ishron256/ToadSuck-Sensor-Test/Hardware/kicad/SmartVent_V3_BOM_testA.csv

 | Value | Datasheet | Footprint | Qty | DNP | Comment | Digi-Key_PN | Manufacturer_Name | Manufacturer_Part_Number | Snaoeda Link | SnapEDA_Link | Snapeda Link | Description
C1,C3,C4,C7,C8,C11,C12,C13,C17,C18,C20 | 0.1 µF | https://www.snapeda.com/parts/0603ZD106KAT2A/AVX/datasheet/ | Capacitor_SMD:C_0603_1608Metric | 11 |  |  |  | AVX | 08055C104KAT4A | https://www.snapeda.com/parts/06035C104MAT4A/KYOCERA%20AVX/view-part/?ab_test_case=b | https://www.snapeda.com/parts/CC0603MRX5R6BB105/Yageo/view-part/?t=1uf%20Capacitor%200603%20&ab_test_case=b | https://www.snapeda.com/parts/0603ZD106KAT2A/AVX/view-part/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 | Unpolarized capacitor,Unpolarized capacitor, small symbol
C2,C14,C15,C19 | 100 µF | https://www.snapeda.com/parts/06035C104MAT4A/KYOCERA%20AVX/datasheet/ | SmartVent_Footprints:SmartVent_Footprint_Capacitor_SMDC_0603_1608Metric_Kyocera_06035C104MAT4A | 4 |  |  |  |  |  |  |  | https://www.snapeda.com/parts/06035C104MAT4A/KYOCERA%20AVX/view-part/?ab_test_case=b | Unpolarized capacitor,Unpolarized capacitor, small symbol
C5,C16 | 22 µF | https://www.snapeda.com/parts/06035C104MAT4A/KYOCERA%20AVX/datasheet/ | Capacitor_SMD:C_0603_1608Metric | 2 |  |  |  | AVX | 06034D226MAT2A |  |  | https://www.snapeda.com/parts/06035C104MAT4A/KYOCERA%20AVX/view-part/?ab_test_case=b | Unpolarized capacitor,Unpolarized capacitor, small symbol
C6 | 1uF | https://www.snapeda.com/parts/CC0603MRX5R6BB105/Yageo/datasheet/ | SmartVent_Footprints:SmartVent_Footprint_C_0603_1608Metric_Yageo_CC0603MRX5R6BB105 | 1 |  |  |  | Yageo | CC0603MRX5R6BB105 |  | https://www.snapeda.com/parts/CC0603MRX5R6BB105/Yageo/view-part/?t=1uf%20Capacitor%200603%20&ab_test_case=b |  | Unpolarized capacitor
C9,C10,C21 | 1.5nF | https://www.snapeda.com/parts/06034D155MAT2A/AVX/datasheet/ | Capacitor_SMD:C_0603_1608Metric | 3 |  |  |  |  |  |  |  |  | Unpolarized capacitor, small symbol
D1,D2,D3,D4,D6,D7 | PDS1040-13 | https://www.snapeda.com/parts/PDS1040-13/Diodes%20Inc./datasheet/ | PDS1040-13:DIO_PDS1040-13 | 6 |  |  |  |  |  |  | https://www.snapeda.com/parts/PDS1040-13/Diodes+Inc./view-part/?ref=snap |  | Diode Schottky 40V 10A 3Pin PowerDI 5 | Diodes Inc PDS1040-13
D5,D9 | LED | https://www.snapeda.com/parts/SMLE12BC7TT86/Rohm/datasheet/ | SML-D12V1WT86:LED_SML-D12V1WT86 | 2 |  |  |  |  |  |  | https://www.snapeda.com/parts/SMLD12V1WT86/Rohm/view-part/?ref=snap |  | Red 630nm LED Indication - Discrete 2.2V 0603 (1608 Metric)
J1 | Pwr In | https://www.molex.com/en-us/products/part-detail/1053092102?display=pdf | Connector_Molex:Molex_Nano-Fit_105309-xx02_1x02_P2.50mm_Vertical | 1 |  |  |  |  |  |  |  |  | Generic connector, single row, 01x02, script generated (kicad-library-utils/schlib/autogen/connector/)
J2 | USB4085-GF-A_REVA4 | https://www.snapeda.com/parts/USB4085-GF-A/Global%20Connector%20Technology/datasheet/ | USB4085-GF-A_REVA4:GCT_USB4085-GF-A_REVA4 | 1 |  |  |  |  |  |  | https://www.snapeda.com/parts/USB4085-GF-A/Global+Connector+Technology/view-part/?ref=snap |  | USB-C (USB TYPE-C) USB 2.0 Receptacle Connector 24 (16+8 Dummy) Position Through Hole, Right Angle, low cost, 3.46mm profile, 16 pin, horizontal, Top mount
J3 | Micro_SD_Card | https://www.we-online.com/components/products/datasheet/693072010801.pdf | SmartVent_Footprints:SmartVent_Footprint_microSD_HC_Wuerth_693072010801 | 1 |  |  |  |  |  |  |  |  | Micro SD Card Socket
J4 | BOOT Jumper | http://www.jst-mfg.com/product/pdf/eng/eXH.pdf | Connector_JST:JST_EH_B3B-EH-A_1x03_P2.50mm_Vertical | 1 |  |  |  |  |  |  |  |  | Generic connector, single row, 01x03, script generated (kicad-library-utils/schlib/autogen/connector/)
J5 | B3B-XH-A | https://www.snapeda.com/parts/B3B-XH-A/JST%20Sales/datasheet/ | B3B-XH-A:JST_B3B-XH-A | 1 |  |  |  |  |  |  | https://www.snapeda.com/parts/B3B-XH-A/JST/view-part/?ref=snap |  | Connector Header Through Hole 3 position 0.098 (2.50mm)
J6,J8 | Snsr Conn | https://www.snapeda.com/parts/B6B-XH-A(LF)(SN)/JST%20Sales%20America%20Inc./datasheet/ | B6B-XH-A_LF__SN_:JST_B6B-XH-A_LF__SN_ | 2 |  |  |  |  |  |  | https://www.snapeda.com/parts/B6B-XH-A(LF)(SN)/JST/view-part/?ref=snap |  | Connector Header Through Hole 6 position 0.098 (2.50mm)
J7 | Ext Fan | http://www.jst-mfg.com/product/pdf/eng/eXH.pdf | B2B_XH_A:JST_B2B-XH-A | 1 |  |  |  |  |  |  |  |  | CONN HEADER VERT 2POS 2.5MM
J15 | FAN 1 | http://www.jst-mfg.com/product/pdf/eng/eXH.pdf | B2B_XH_A:JST_B2B-XH-A | 1 |  |  | 455-2247-ND |  |  |  |  |  | CONN HEADER VERT 2POS 2.5MM
J17 | FAN 2 | http://www.jst-mfg.com/product/pdf/eng/eXH.pdf | B2B_XH_A:JST_B2B-XH-A | 1 |  |  | 455-2247-ND |  |  |  |  |  | CONN HEADER VERT 2POS 2.5MM
Q1,Q4,Q6 | DMP6023LFG-7 | https://www.diodes.com//assets/Datasheets/DMP6023LFG.pdf | LIB_DMP6023LFG-7:DMP4013LFG7 | 3 |  |  |  | Diodes Incorporated | DMP6023LFG-7 |  |  |  | MOSFET P-Ch 60V Enh Mode 20Vgs 53.1nC 2569pF
Q2,Q3,Q5 | 2N7002K | https://www.diodes.com/assets/Datasheets/ds30896.pdf | Package_TO_SOT_SMD:SOT-23 | 3 |  |  |  |  |  |  |  |  | 0.38A Id, 60V Vds, N-Channel MOSFET, SOT-23
R1 | 5.1k Ohm | https://www.snapeda.com/parts/ERA-3VEB5101V/Panasonic%20Electronic%20Components/view-part/ | Resistor_SMD:R_0603_1608Metric | 1 |  |  |  |  |  |  |  | https://www.snapeda.com/parts/ERA-3VEB5101V/Panasonic%20Electronic%20Components/view-part/ | Resistor, small US symbol
R2,R3,R32 | 10 Ohm | https://www.snapeda.com/parts/RCP0603B10R0JS2/Vishay/datasheet/,https://www.vishay.com/docs/20035/dcrcwe3.pdf | Resistor_SMD:R_0603_1608Metric | 3 |  |  |  |  |  |  |  |  | Resistor,Resistor, small US symbol
R4,R5,R6,R8,R10,R14,R16,R19,R20,R21,R27,R29,R30,R31 | 10K Ohm | https://www.snapeda.com/parts/CRGCQ0805F10K/TE%20Connectivity/datasheet/ | Resistor_SMD:R_0603_1608Metric | 14 |  |  |  |  |  |  | https://www.snapeda.com/parts/CRGCQ0603F10K/TE%20Connectivity/view-part/ |  | Resistor, small US symbol
R7,R13,R28 | 27 Ohm | https://www.snapeda.com/parts/CRCW060327R0FKEA/Vishay%20Dale/datasheet/ | Resistor_SMD:R_0603_1608Metric | 3 |  |  |  |  |  |  |  |  | Resistor, small US symbol
R9,R18 | 10K Ohm | https://www.snapeda.com/parts/CRGCQ0603F10K/TE%20Connectivity/datasheet/ | Resistor_SMD:R_0603_1608Metric | 2 |  |  |  |  |  |  | https://www.snapeda.com/parts/CRGCQ0603F10K/TE%20Connectivity/view-part/ |  | Resistor, small US symbol
R11 | 330 Ohm | https://www.snapeda.com/parts/ERJ-S03J331V/Panasonic/datasheet/ | Resistor_SMD:R_0603_1608Metric | 1 |  |  |  |  |  |  | https://www.snapeda.com/parts/ERJ-S03J331V/Panasonic/view-part/?t=330%20Ohm%200608%20resistor&ab_test_case=b |  | Resistor, small US symbol
R12 | 560 Ohm | https://www.snapeda.com/parts/ERJ-8ENF5600V/Panasonic/datasheet/ | Resistor_SMD:R_0603_1608Metric | 1 |  |  |  |  |  |  | https://www.snapeda.com/parts/ERA-3VEB5600V/Panasonic%20Electronic%20Components/view-part/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 |  | Resistor, small US symbol
R15,R26 | 1K Ohm | https://www.snapeda.com/parts/MCT06030E1001BP500/Vishay/view-part/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 | Resistor_SMD:R_0603_1608Metric | 2 |  |  |  |  |  |  |  |  | Resistor, small US symbol
R17 | 4700 Ohm | https://www.snapeda.com/parts/ERJ-S03F4700V/Panasonic/datasheet/ | Resistor_SMD:R_0603_1608Metric | 1 |  |  |  |  |  |  | https://www.snapeda.com/parts/RSF1JB1K00/SEI%20Stackpole%20Electronics/view-part/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 |  | Resistor, small US symbol
R22 | 5.1k Ohm | https://www.snapeda.com/parts/AC0603FR-135K1L/Yageo/view-part/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 | Resistor_SMD:R_0603_1608Metric | 1 |  |  |  |  |  |  |  |  | Resistor, small US symbol
R23 | 100K Ohm | https://www.snapeda.com/parts/RT0603BRB07100KL/Yageo/datasheet/ | Resistor_SMD:R_0603_1608Metric | 1 |  |  |  |  |  |  |  |  | Resistor, small US symbol
R24 | 120K Ohm | https://www.snapeda.com/parts/ERJPA3D1203V/Panasonic/datasheet/ | Resistor_SMD:R_0603_1608Metric | 1 |  |  |  |  |  |  |  |  | Resistor, small US symbol
R25 | 100 Ohm | https://www.snapeda.com/parts/RT0603BRB07100KL/Yageo/datasheet/ | Resistor_SMD:R_0603_1608Metric | 1 |  |  |  |  |  |  |  |  | Resistor, small US symbol
S2 | 1825967-1 | https://www.snapeda.com/parts/1825967-1/TE%20Connectivity/datasheet/ | 1825967-1:SW_1825967-1 | 1 |  | 1825967-1 |  |  |  |  | https://www.snapeda.com/parts/1825967-1/TE+Connectivity+%252F+DEUTSCH/view-part/?ref=snap |  | Switch Tactile OFF (ON) SPST Round Button PC Pins 0.05A 24VDC 1.57N Thru-Hole
U1 | TPD4E001DRLRG4 | https://www.snapeda.com/parts/SDA004-7/Diodes%20Inc./datasheet/ | TPD4E001DRLRG4:SOTFL50P160X60-6N | 1 |  |  |  |  |  |  | https://www.snapeda.com/parts/TPD4E001DRLRG4/Texas+Instruments/view-part/?ref=snap |  | Low-capacitance 4-channel +/-15-k-V ESD protection array for high-speed data interfaces 6-SOT-5X3 -40 to 85
U2 | ESP32-S3-WROOM-1 | https://www.espressif.com/sites/default/files/documentation/esp32-s3-wroom-1_wroom-1u_datasheet_en.pdf | Library_2:XCVR_ESP32-S3-WROOM-1-N4_EP | 1 |  |  |  |  |  |  |  |  | 2.4 GHz WiFi (802.11 b/g/n) and Bluetooth Â® 5 (LE) module Built around ESP32S3 series of SoCs, Xtensa Â® dualcore 32bit LX7 microprocessor Flash up to 16 MB, PSRAM up to 8 MB 36 GPIOs, rich set of peripherals Onboard PCB antenna
U3 | BME280 | https://www.bosch-sensortec.com/media/boschsensortec/downloads/datasheets/bst-bme280-ds002.pdf | Package_LGA:Bosch_LGA-8_2.5x2.5mm_P0.65mm_ClockwisePinNumbering | 1 |  |  |  |  |  |  |  |  | 3-in-1 sensor, humidity, pressure, temperature, I2C and SPI interface, 1.71-3.6V, LGA-8
U4 | TPD3E001DRLRG4 | https://www.snapeda.com/parts/TPD3E001DRLRG4/Texas%20Instruments/datasheet/ | TPD3E001DRLRG4:SOT50P160X60-5N | 1 |  |  |  |  |  |  | https://www.snapeda.com/parts/TPD3E001DRLRG4/Texas+Instruments/view-part/?ref=snap |  | Low-capacitance 3-channel +/-15K-V ESD-protection array for high-speed data interfaces 5-SOT-5X3 -40 to 85
U11 | LM317 | http://www.ti.com/lit/ds/symlink/lm317.pdf | Package_TO_SOT_SMD:SOT-223-3_TabPin2 | 1 |  |  |  |  |  |  | https://www.snapeda.com/parts/LM317AT/Texas%20Instruments/view-part/?ref=search&t=LM317 |  | 1.5A 35V Adjustable Linear Regulator, SOT-223
