ishron256/ToadSuck-Sensor-Test/Hardware/kicad/SmartVent_V3.pdf

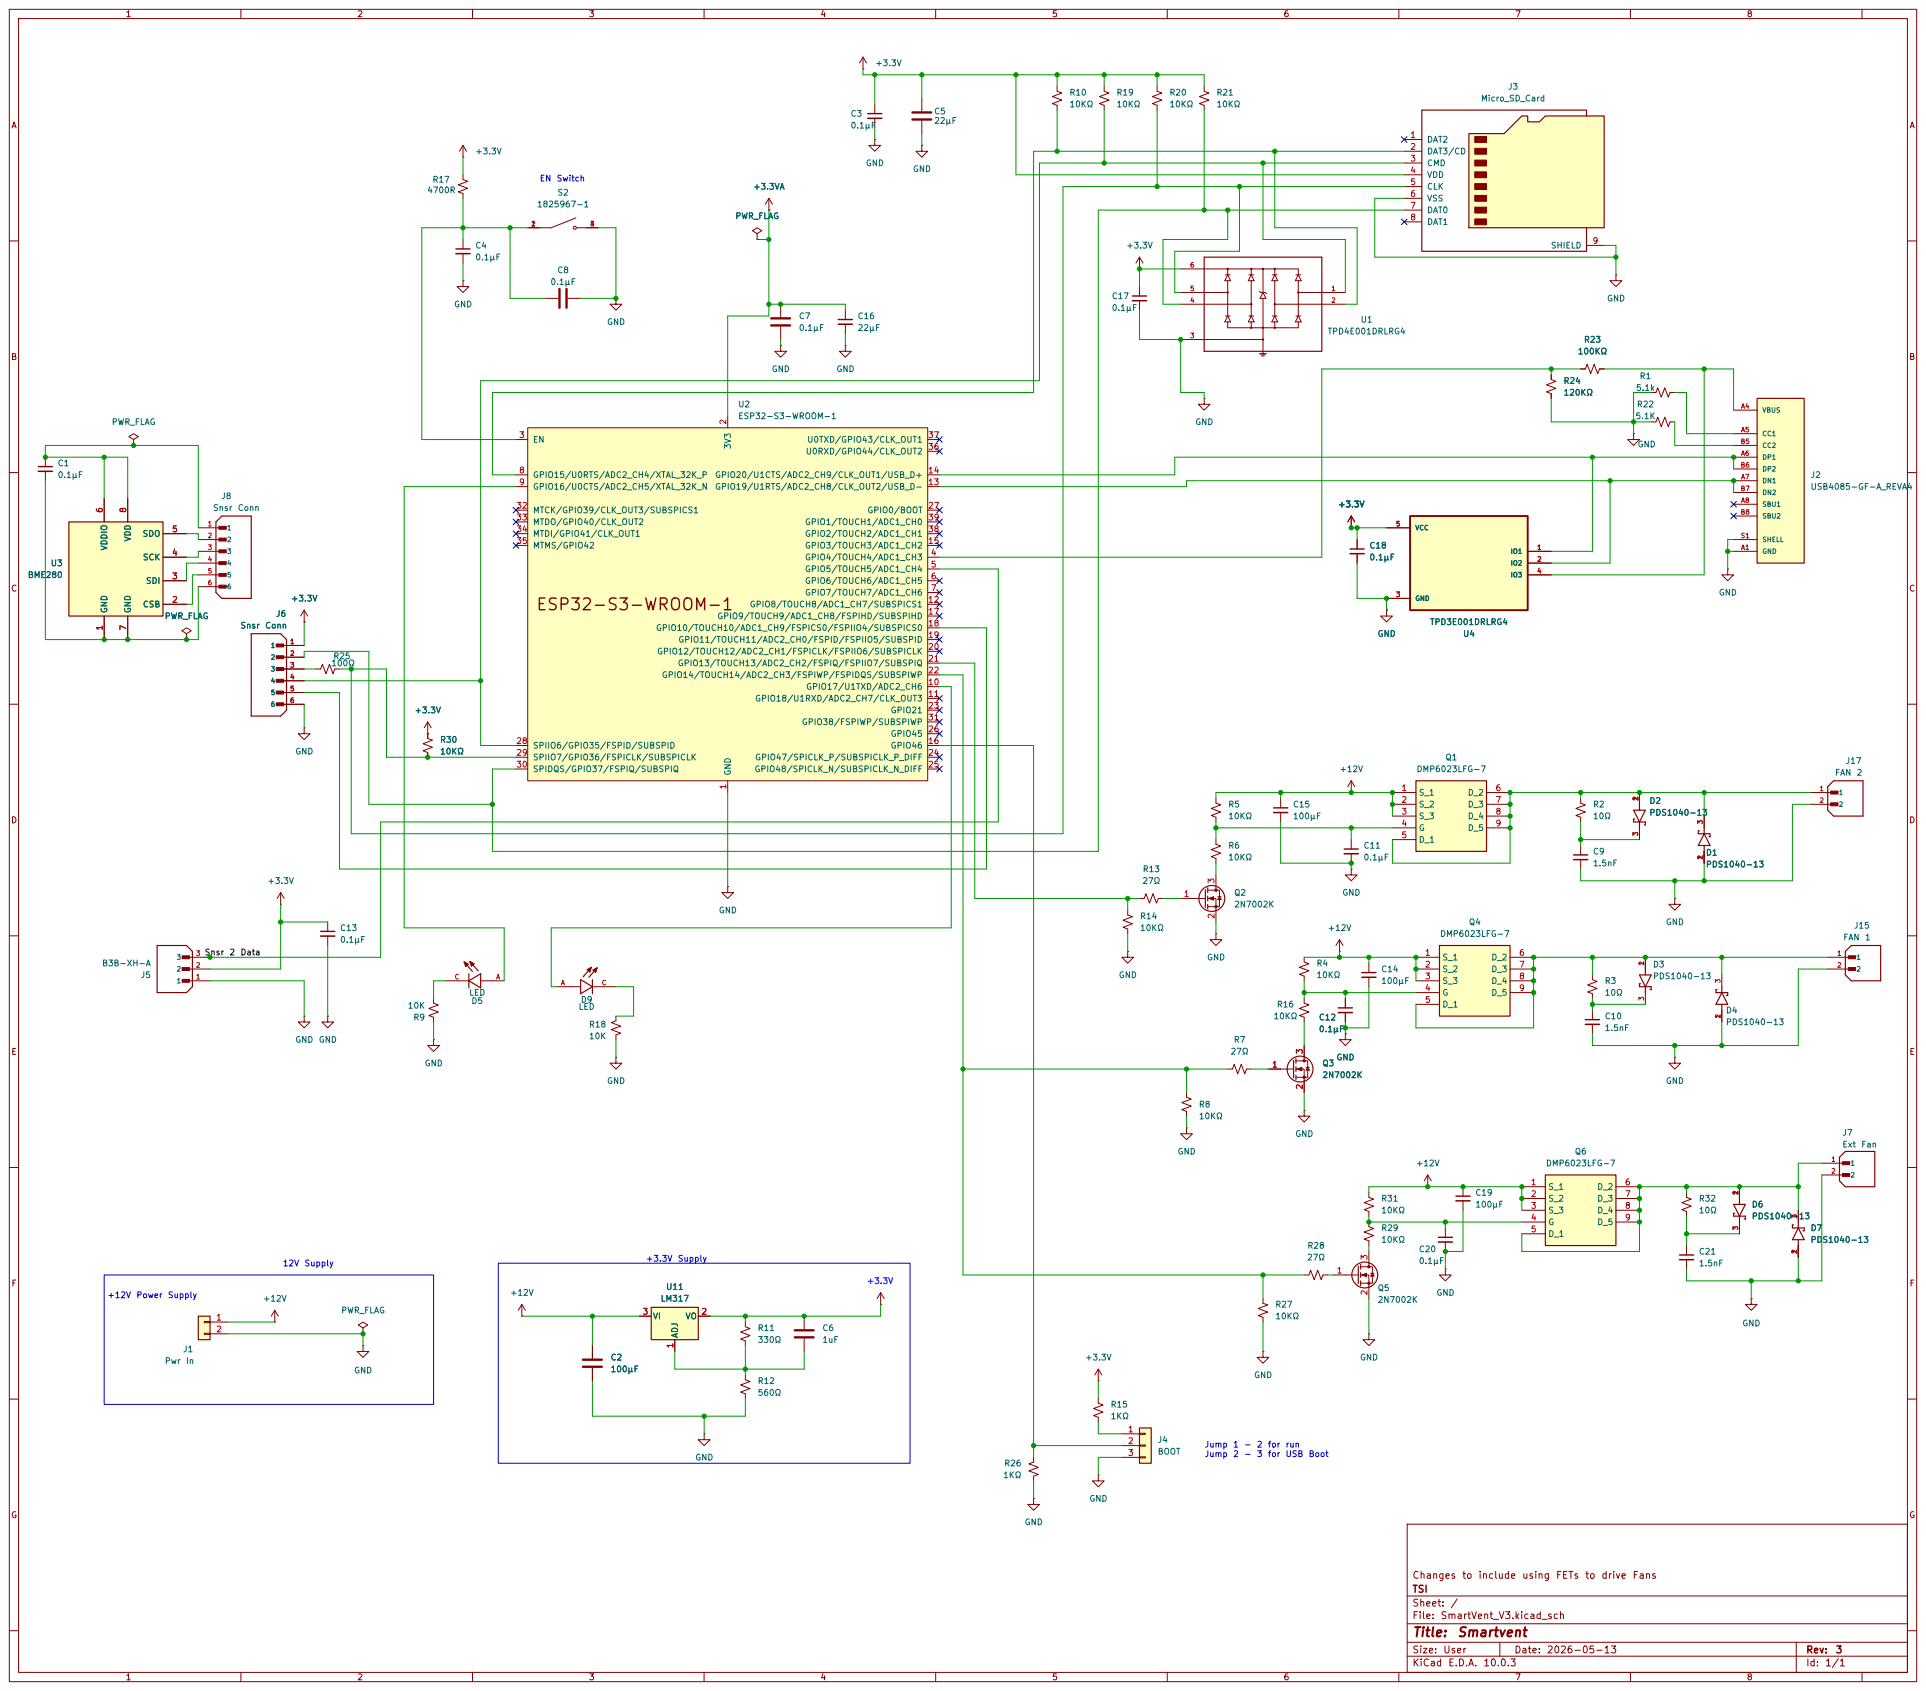
[picture p1: page 1]

Jump 2 - 3 for USB Boot +3.3V Supply 12V Supply

Changes to include using FETs to drive Fans R11

Size: User | Rev: 3
KiCad E.D.A. 10.0.3 | Id: 1/1
