ishron256/ToadSuck-Sensor-Test/Hardware/kicad/SmartVent_V3-B_Cu.pdf

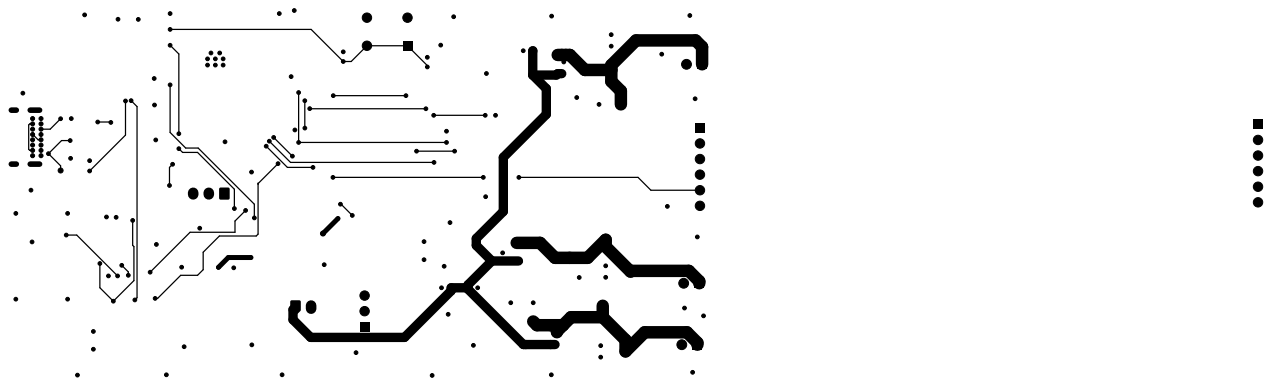
[picture p2: page 1]
