ishron256/ToadSuck-Sensor-Test/Hardware/kicad/SmartVent_V3-B_Mask.pdf

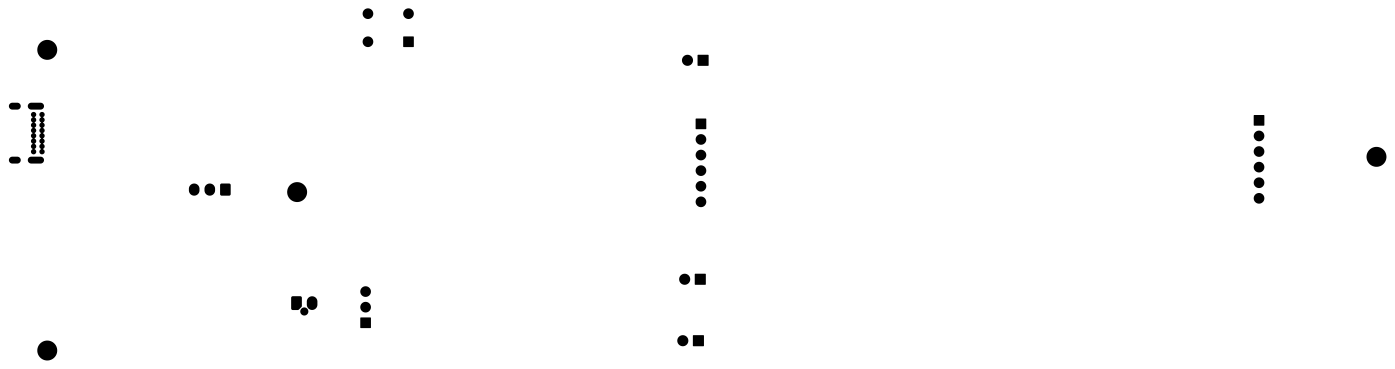
[picture p3: page 1]
