ishron256/ToadSuck-Sensor-Test/Hardware/kicad/SmartVent_V3-F_Cu.pdf

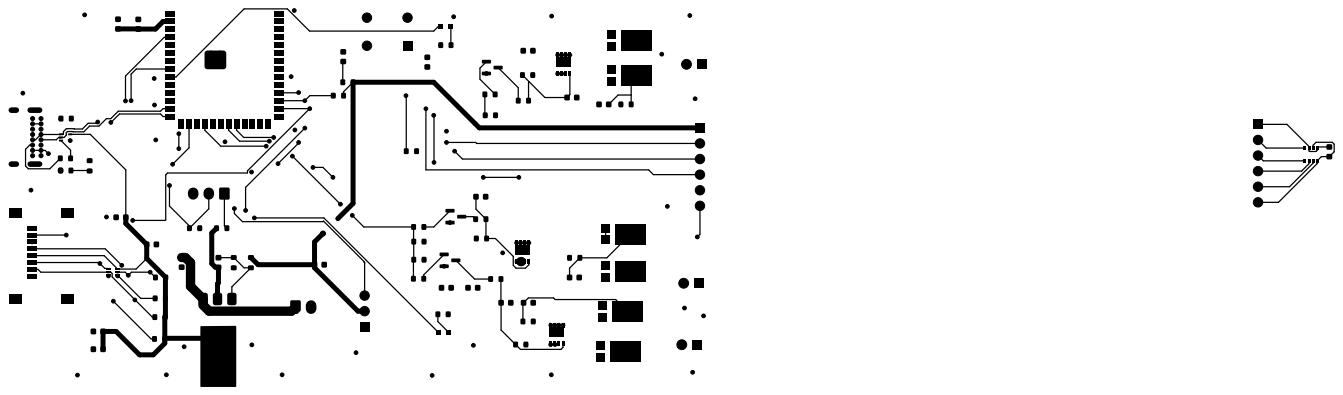
[picture p4: page 1]
