ishron256/ToadSuck-Sensor-Test/Hardware/kicad/SmartVent_V3-F_Mask.pdf

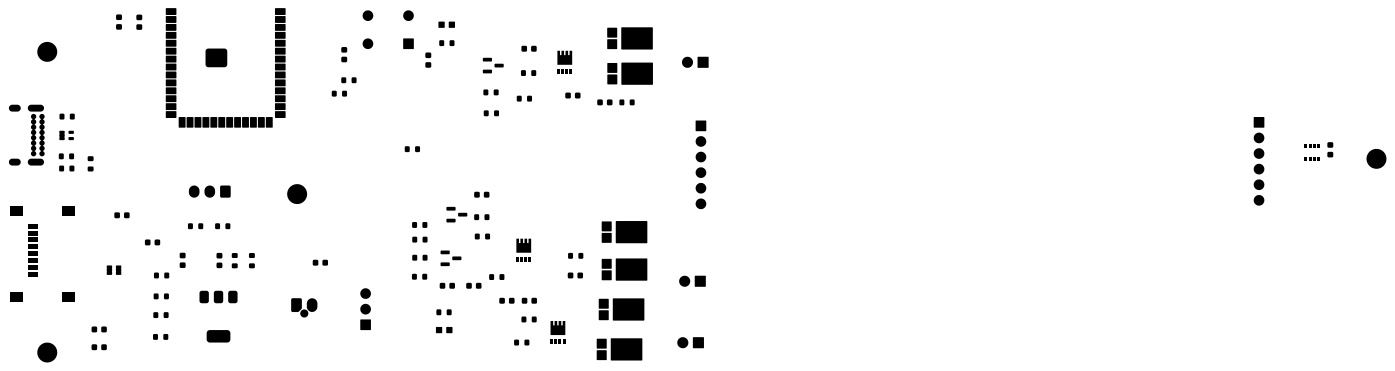
[picture p5: page 1]
