ishron256/ToadSuck-Sensor-Test/Hardware/kicad/SmartVent_V3-F_Paste.pdf

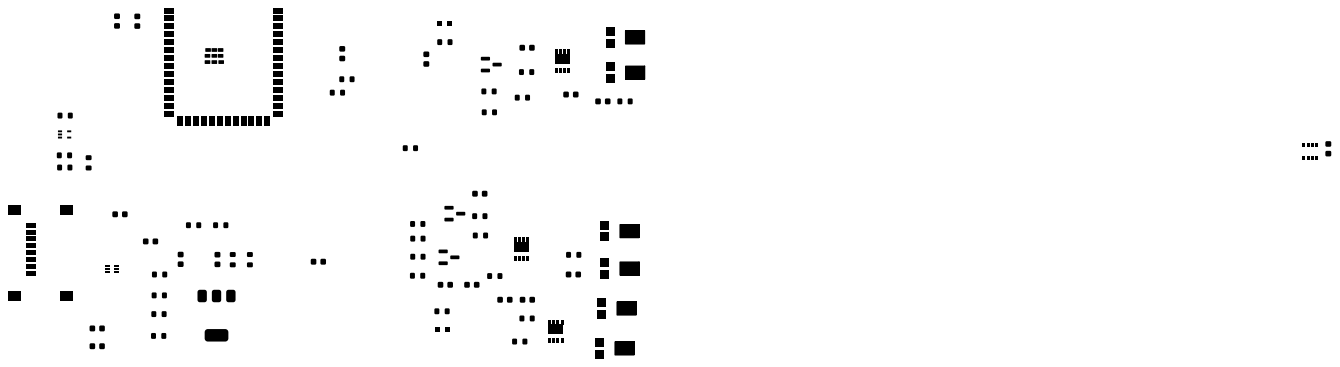
[picture p6: page 1]
