ishron256/ToadSuck-Sensor-Test/Hardware/kicad/SmartVent_V3-F_Silkscreen.pdf

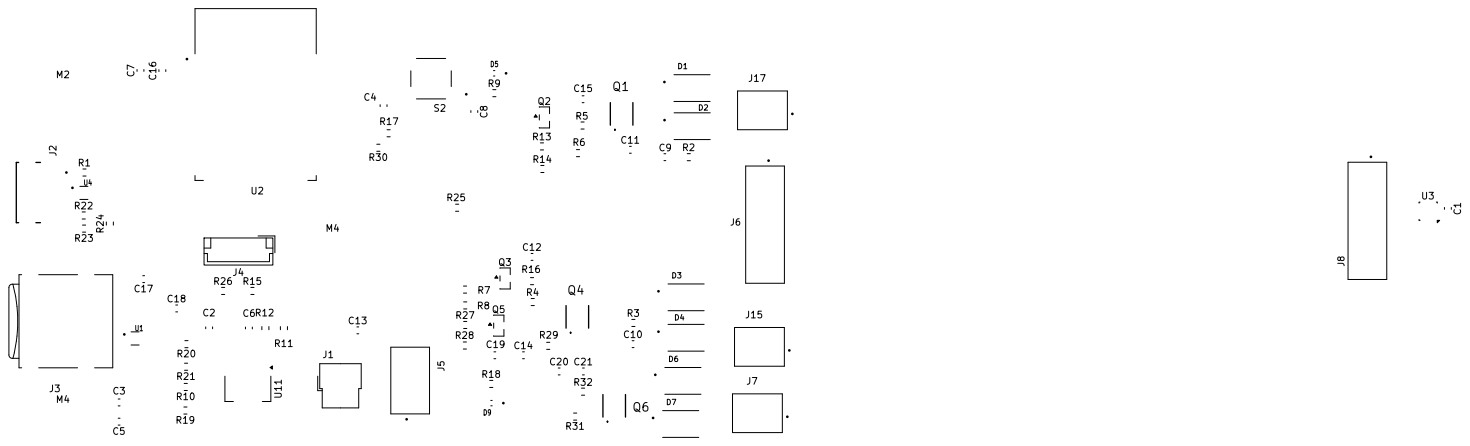
[picture p7: page 1]
