ishron256/ToadSuck-Sensor-Test/Hardware/kicad/SmartVent_V3-In1_Cu.pdf

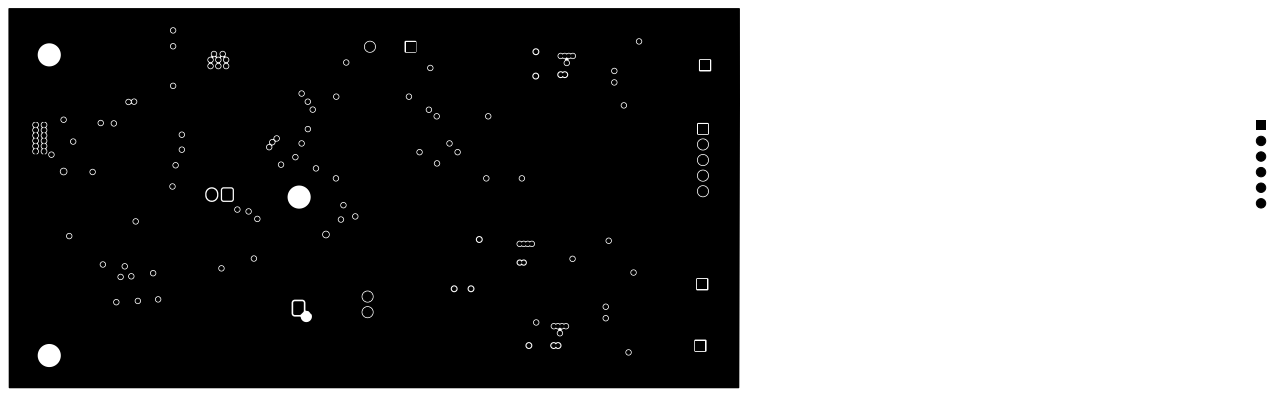
[picture p8: page 1]
