ishron256/ToadSuck-Sensor-Test/Hardware/kicad/SmartVent_V3-In2_Cu.pdf

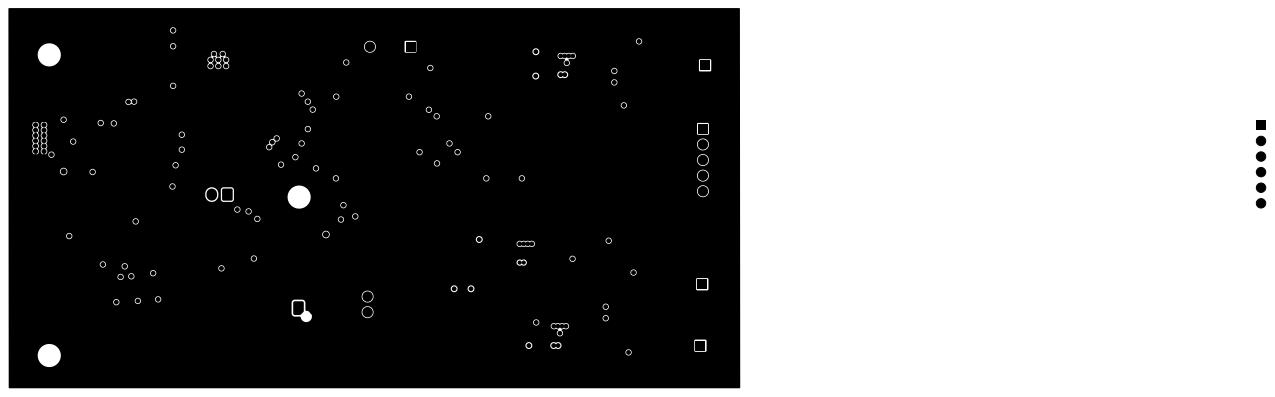
[picture p9: page 1]
