ishron256/ToadSuck-Sensor-Test/Hardware/kicad/SmartVent_V3.kicad_pcb

## KiCad design Hardware/kicad/SmartVent_V3.kicad_pcb (2026-10-24)

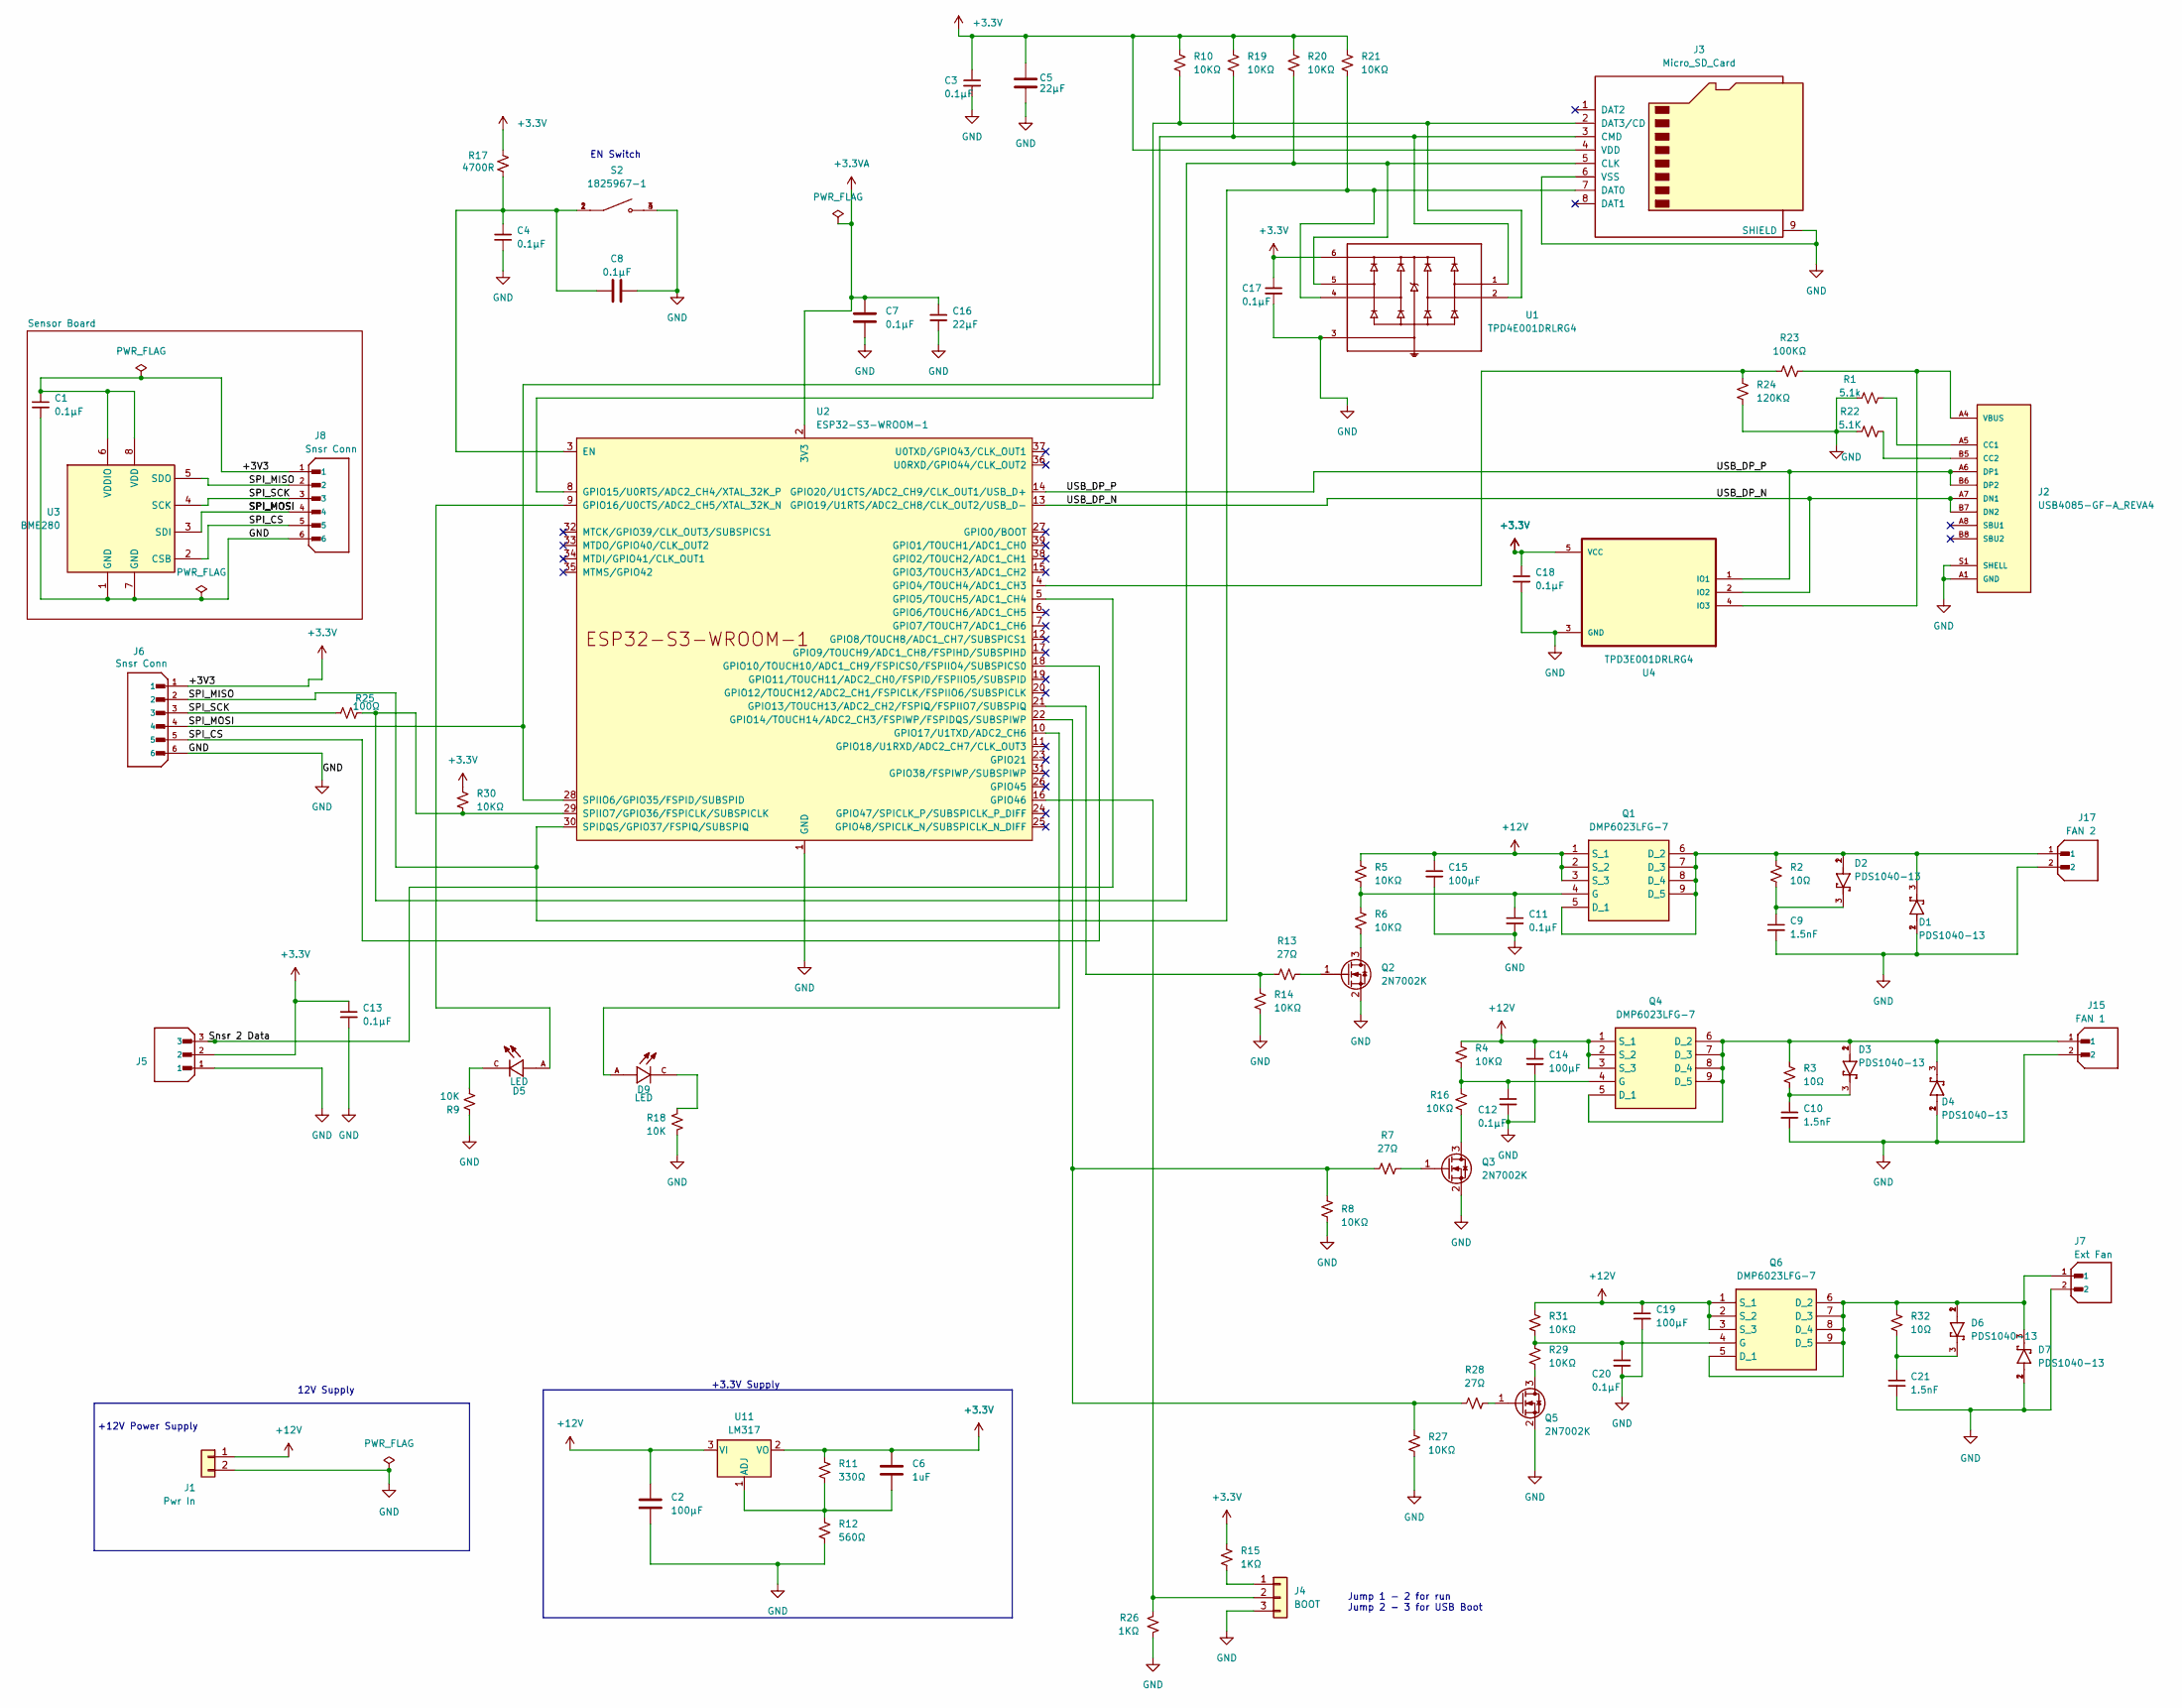
[picture p10: schematic SmartVent_V3.kicad_sch, Smartvent]

Parts:
C1, C4, C7, C8, C11, C12, C13, C17, C18, C20: 0.1µF; C_0603_1608Metric
C2, C14, C15, C19: 100µF; SmartVent_Footprint_Capacitor_SMDC_0603_1608Metric_Kyocera_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
C3: 0.1µF; C_0603_1608Metric; Voltage 6.3V; Tolerance 20%
C5, C16: 22µF; C_0603_1608Metric
C6: 1uF; SmartVent_Footprint_C_0603_1608Metric_Yageo_CC0603MRX5R6BB1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
C9, C10, C21: 1.5nF; C_0603_1608Metric
D1, D2, D3, D4, D6, D7: PDS1040-13; DIO_PDS1040-13; PARTREV 13
D5, D9: LED; LED_SML-D12V1WT86; PARTREV 007
J1: Pwr In; Molex_Nano-Fit_105309-xx02_1x02_P2.50mm_Vertical
J2: USB4085-GF-A_REVA4; GCT_USB4085-GF-A_REVA4; PARTREV A4
J3: Micro_SD_Card; SmartVent_Footprint_microSD_HC_Wuerth_693072010801
J4: BOOT; JST_EH_B3B-EH-A_1x03_P2.50mm_Vertical
J5: B3B-XH-A; JST_B3B-XH-A; PARTREV 7/4/21
J6, J8: Snsr Conn; JST_B6B-XH-A_LF__SN_; PARTREV 7/4/21
J7: Ext Fan; JST_B2B-XH-A; PARTREV N/A
J15: FAN 1; JST_B2B-XH-A; MPN B2B-XH-A(LF)(SN); Digi-Key_PN 455-2247-ND
J17: FAN 2; JST_B2B-XH-A; MPN B2B-XH-A(LF)(SN); Digi-Key_PN 455-2247-ND
Q1, Q4, Q6: DMP6023LFG-7; DMP4013LFG7; Mouser Part Number 621-DMP6023LFG-7
Q2, Q3, Q5: 2N7002K; SOT-23
R1: 5.1k; R_0603_1608Metric
R2, R3, R32: 10Ω; R_0603_1608Metric
R4, R5, R6, R8, R10, R14, R16, R19, R20, R21, R27, R29, R30, R31: 10KΩ; R_0603_1608Metric
R7, R13, R28: 27Ω; R_0603_1608Metric
R9, R18: 10K; R_0603_1608Metric
R11: 330Ω; R_0603_1608Metric
R12: 560Ω; R_0603_1608Metric
R15, R26: 1KΩ; R_0603_1608Metric
R17: 4700R; R_0603_1608Metric
R22: 5.1K; R_0603_1608Metric
R23: 100KΩ; R_0603_1608Metric
R24: 120KΩ; R_0603_1608Metric
R25: 100Ω; R_0603_1608Metric
S2: 1825967-1; SW_1825967-1; PARTREV E
U1: TPD4E001DRLRG4; SOTFL50P160X60-6N; MPN SDA004-7
U2: ESP32-S3-WROOM-1; XCVR_ESP32-S3-WROOM-1-N4_EP
U3: BME280; Bosch_LGA-8_2.5x2.5mm_P0.65mm_ClockwisePinNumbering
U4: TPD3E001DRLRG4; SOT50P160X60-5N
U11: LM317; SOT-223-3_TabPin2

Connections:
+3.3V: C1.1, C3.1, C5.1, C6.1, C13.1, C17.1, C18.1, J3.4 (VDD), J5.2, J6.1, J8.1, R10.1, R11.1, R15.1, R17.2, R19.1, R20.1, R21.1, R30.1, U1.6, U3.6 (VDDIO), U3.8 (VDD), U4.5 (VCC), U11.2 (VO)
+3.3VA: C7.1, C16.1, U2.2 (3V3)
+12V: C2.1, C14.1, C15.1, C19.1, J1.1, Q1.1 (S_1), Q1.2 (S_2), Q1.3 (S_3), Q4.1 (S_1), Q4.2 (S_2), Q4.3 (S_3), Q6.1 (S_1), Q6.2 (S_2), Q6.3 (S_3), R4.1, R5.1, R31.1, U11.3 (VI)
/SPI_CS: J6.5, J8.5, U2.18 (GPIO10/TOUCH10/ADC1_CH9/FSPICS0/FSPIIO4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), U3.2 (CSB)
/SPI_MISO: J3.7 (DAT0), J6.2, J8.2, R21.2, U1.4, U2.30 (SPIDQS/GPIO37/FSPIQ/SUBSPIQ), U3.5 (SDO)
/SPI_SCK: J6.3, J8.3, R25.2, U3.4 (SCK)
/Snsr 2 Data: J5.3, U2.5 (GPIO5/TOUCH5/ADC1_CH4)
/USB_DP_N: J2.A7 (DN1), J2.B7 (DN2), U2.13 (GPIO19/U1RTS/ADC2_CH8/CLK_OUT2/USB_D-), U4.2 (IO2)
/USB_DP_P: J2.A6 (DP1), J2.B6 (DP2), U2.14 (GPIO20/U1CTS/ADC2_CH9/CLK_OUT1/USB_D+), U4.1 (IO1)
GND: C1.2, C2.2, C3.2, C4.2, C5.2, C7.2, C8.1, C9.2, C10.2, C11.2, C12.2, C13.2, C14.2, C15.2, C16.2, C17.2, C18.2, C19.2, C20.2, C21.2, D1.1, D1.2, D4.1, D4.2, D7.1, D7.2, J1.2, J2.A1 (GND), J2.A12 (GND), J2.B1 (GND), J2.B12 (GND), J2.S1 (SHELL), J2.S2 (SHELL), J2.S3 (SHELL), J2.S4 (SHELL), J3.6 (VSS), J3.9 (SHIELD), J4.3, J5.1, J6.6, J7.2, J8.6, J15.2, J17.2, Q2.2 (S), Q3.2 (S), Q5.2 (S), R1.2, R8.2, R9.1, R12.2, R14.2, R18.2, R22.2, R24.2, R26.2, R27.2, S2.3, S2.4, U1.3, U2.1 (GND), U2.40 (GND), U2.41 (GND), U3.1 (GND), U3.7 (GND), U4.3 (GND)
unnamed: C9.1, D2.3, R2.2
unnamed: C10.1, D3.3, R3.2
unnamed: C21.1, D6.3, R32.2
unnamed: D5.C, R9.2
unnamed: D9.C, R18.1
unnamed: J2.A5 (CC1), R1.1
unnamed: J2.B5 (CC2), R22.1
unnamed: J3.5 (CLK), R20.2, R25.1, R30.2, U1.5, U2.29 (SPIIO7/GPIO36/FSPICLK/SUBSPICLK)
unnamed: J3.2 (DAT3/CD), R10.2, U1.2, U2.8 (GPIO15/U0RTS/ADC2_CH4/XTAL_32K_P)
unnamed: J4.1, R15.2
unnamed: J4.2, R26.1, U2.16 (GPIO46)
unnamed: D1.3, D2.1, D2.2, J17.1, Q1.5 (D_1), Q1.6 (D_2), Q1.7 (D_3), Q1.8 (D_4), Q1.9 (D_5), R2.1
unnamed: C11.1, Q1.4 (G), R5.2, R6.1
unnamed: Q2.3 (D), R6.2
unnamed: Q2.1 (G), R13.2
unnamed: Q3.3 (D), R16.1
unnamed: Q3.1 (G), R7.2
unnamed: D3.1, D3.2, D4.3, J15.1, Q4.5 (D_1), Q4.6 (D_2), Q4.7 (D_3), Q4.8 (D_4), Q4.9 (D_5), R3.1
unnamed: C12.1, Q4.4 (G), R4.2, R16.2
unnamed: Q5.3 (D), R29.2
unnamed: Q5.1 (G), R28.1
unnamed: D6.1, D6.2, D7.3, J7.1, Q6.5 (D_1), Q6.6 (D_2), Q6.7 (D_3), Q6.8 (D_4), Q6.9 (D_5), R32.1
unnamed: C20.1, Q6.4 (G), R29.1, R31.2
unnamed: C4.1, C8.2, R17.1, S2.1, S2.2, U2.3 (EN)
unnamed: R23.1, R24.1, U2.4 (GPIO4/TOUCH4/ADC1_CH3)
unnamed: R13.1, R14.1, U2.21 (GPIO13/TOUCH13/ADC2_CH2/FSPIQ/FSPIIO7/S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)
unnamed: R7.1, R8.1, R27.1, R28.2, U2.22 (GPIO14/TOUCH14/ADC2_CH3/FSPIWP/FSPIDQS/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)
unnamed: D5.A, U2.9 (GPIO16/U0CTS/ADC2_CH5/XTAL_32K_N)
unnamed: D9.A, U2.10 (GPIO17/U1TXD/ADC2_CH6)
unnamed: C6.2, R11.2, R12.1, U11.1 (ADJ)
VBUS: J2.A4 (VBUS), J2.A9 (VBUS), J2.B4 (VBUS), J2.B9 (VBUS), R23.2, U4.4 (IO3)

Notes on the sheet:
Jump 1 - 2 for run Jump 2 - 3 for USB Boot
12V Supply
+12V Power Supply
EN Switch
+3.3V Supply

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
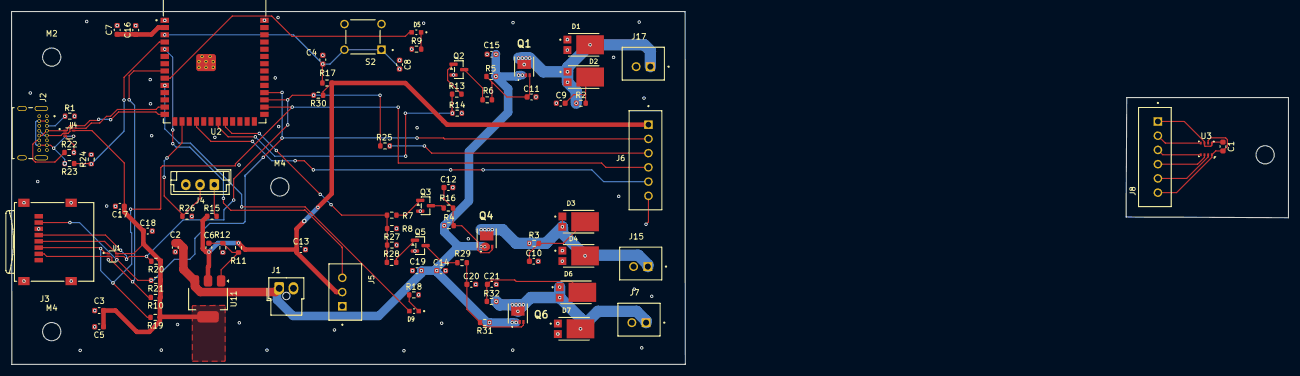
[picture p11: board SmartVent_V3.kicad_pcb from above]

Board: 4 copper layers, 118.3 x 61.9 mm, 87 parts (0 on the bottom side), 43 nets.

Other parts of the board:
M1, M2, M4, M4#2: MountingHole_3.2mm_M3
