ishron256/ToadSuck-Sensor-Test/(commit log)

2026-10-19 Convert to PlatformIO (espidf framework), update notes
2026-10-24 Add SmartVent V3 Gerbers, netlist, BOM and PDFs
    [SmartVent_V3-B_Cu.gbr, SmartVent_V3-B_Mask.gbr, SmartVent_V3-B_Paste.gbr, SmartVent_V3-B_Silkscreen.gbr, SmartVent_V3-Edge_Cuts.gbr, SmartVent_V3-F_Cu.gbr, SmartVent_V3-F_Mask.gbr, SmartVent_V3-F_Paste.gbr]
2026-10-24 Fix SD CS pin and BME280 bus from netlist review; update notes
    [SmartVent_V3.kicad_sch]
2026-10-24 Add SmartVent_V3.kicad_sch; flag stale netlist in notes
2026-10-24 Add latest KiCad PCB/project; update hardware review in notes
    [SmartVent_V3.kicad_pcb]
2026-10-24 Notes: BME280 MOSI via J8-J6 cable, SD clock net confirmed
2026-10-24 Add SPI BME280 driver and shared SPI bus init
2026-10-24 Take inside reading at end of fan run/startup test
2026-10-25 Notes: record 3V3 LM317 rail fault found during bring-up
2026-11-01 Add BME280 bit-bang test env, log sensor readings, record bring-up results
